mpdg837/BilberryPI/demo1.jpg

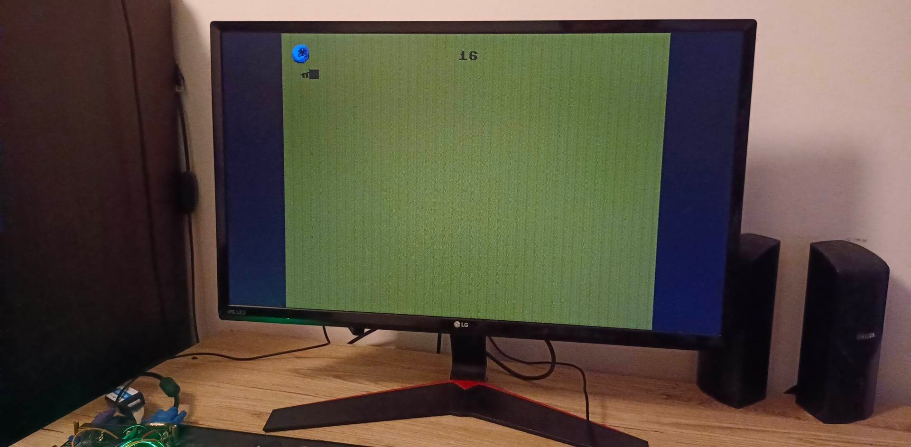
demo1.jpg
