mpdg837/BilberryPI/Hardware/GRAPHICS/PaletteController.v

module deltaController(
	input clk,
	input rst,
	
	input[23:0] in,
	input start,
	
	output reg delirq,
	
	output splash,
	
	output reg[4:0] deltaY,
	output reg[6:0] deltaX,
	
	output reg[4:0] bg1col1,
	output reg[4:0] bg1col2,
	output reg[4:0] bg1col3,
	output reg[4:0] bg1col4,
	
	output reg[4:0] bg2col1,
	output reg[4:0] bg2col2,
	output reg[4:0] bg2col3,
	output reg[4:0] bg2col4,
	
	output reg[4:0] bg3col1,
	output reg[4:0] bg3col2,
	output reg[4:0] bg3col3,
	output reg[4:0] bg3col4,
	
	output reg[4:0] bg4col1,
	output reg[4:0] bg4col2,
	output reg[4:0] bg4col3,
	output reg[4:0] bg4col4,
	
	output reg[4:0] bg5col1,
	output reg[4:0] bg5col2,
	output reg[4:0] bg5col3,
	output reg[4:0] bg5col4,
	
	output reg[4:0] bg6col1,
	output reg[4:0] bg6col2,
	output reg[4:0] bg6col3,
	output reg[4:0] bg6col4,
	
	output reg[4:0] bg7col1,
	output reg[4:0] bg7col2,
	output reg[4:0] bg7col3,
	output reg[4:0] bg7col4,
	
	output reg[4:0] bg8col1,
	output reg[4:0] bg8col2,
	output reg[4:0] bg8col3,
	output reg[4:0] bg8col4
	
);
reg n_splash =0;
reg f_splash = 0;

reg[4:0] f_deltaY;
reg[6:0] f_deltaX;

reg[4:0] f_bg1col1;
reg[4:0] f_bg1col2;
reg[4:0] f_bg1col3;
reg[4:0] f_bg1col4;

reg[4:0] f_bg2col1;
reg[4:0] f_bg2col2;
reg[4:0] f_bg2col3;
reg[4:0] f_bg2col4;

reg[4:0] f_bg3col1;
reg[4:0] f_bg3col2;
reg[4:0] f_bg3col3;
reg[4:0] f_bg3col4;

reg[4:0] f_bg4col1;
reg[4:0] f_bg4col2;
reg[4:0] f_bg4col3;
reg[4:0] f_bg4col4;

reg[4:0] f_bg5col1;
reg[4:0] f_bg5col2;
reg[4:0] f_bg5col3;
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
							bg6col4 = in[9:5];
						end
						6: begin
							bg7col3 = in[4:0];
							bg7col4 = in[9:5];
						end
						7: begin
							bg8col3 = in[4:0];
							bg8col4 = in[9:5];
						end
						default:;
					endcase
			default:;
		endcase
	
end

assign splash = ~n_splash;

endmodule
