mpdg837/BilberryPI/Hardware/GRAPHICS/sprites.v

module sprites(
	input clk,
	input dclk,
	input rst,
	input splash,
	
	input[3:0] uiin,
	
	input[4:0] bgcol2,
	input[4:0] bgcol3,
	input[4:0] bgcol4,
	
	input[8:0] ccy,
	input[9:0] ccx,
		
	input[31:0] fromRAM,
	output[15:0] addr,

	input[4:0] bcgcol,
	
	input xhsync,
	input xvsync,
	
	input ins,
	input sig,
	
	input[9:0] CounterX,
	input[8:0] CounterY,
	
	output comb,
	
	output R,
	output G,
	output B,
	
	output hsync,
	output vsync

	
);

wire[8:0] posX1;
wire[31:0] colors1;

wire[4:0] b1col1;
wire[4:0] b1col2;
wire[4:0] b1col3;
wire[4:0] b1col4;


wire[8:0] posX2;
wire[31:0] colors2;

wire[4:0] b2col1;
wire[4:0] b2col2;
wire[4:0] b2col3;
wire[4:0] b2col4;



wire[8:0] posX3;
wire[31:0] colors3;

wire[4:0] b3col1;
wire[4:0] b3col2;
wire[4:0] b3col3;
wire[4:0] b3col4;



wire[8:0] posX4;
wire[31:0] colors4;

wire[4:0] b4col1;
wire[4:0] b4col2;
wire[4:0] b4col3;
wire[4:0] b4col4;



wire[8:0] posX5;
wire[31:0] colors5;

wire[4:0] b5col1;
wire[4:0] b5col2;
wire[4:0] b5col3;
wire[4:0] b5col4;



wire[8:0] posX6;
wire[31:0] colors6;

wire[4:0] b6col1;
wire[4:0] b6col2;
wire[4:0] b6col3;
wire[4:0] b6col4;



wire[8:0] posX7;
wire[31:0] colors7;

wire[4:0] b7col1;
wire[4:0] b7col2;
wire[4:0] b7col3;
wire[4:0] b7col4;



wire[8:0] posX8;
wire[31:0] colors8;

wire[4:0] b8col1;
wire[4:0] b8col2;
wire[4:0] b8col3;
wire[4:0] b8col4;



wire[3:0] sclX1;
wire[3:0] sclX2;
wire[3:0] sclX3;
wire[3:0] sclX4;
wire[3:0] sclX5;
wire[3:0] sclX6;
wire[3:0] sclX7;
wire[3:0] sclX8;

wire swpX1;
wire swpX2;
wire swpX3;
wire swpX4;
wire swpX5;
wire swpX6;
wire swpX7;
wire swpX8;


wire[8:0] posX;
wire[31:0] colors;

wire[4:0] bcol1;
wire[4:0] bcol2;
wire[4:0] bcol3;
wire[4:0] bcol4;
wire[3:0] sclX;
wire swpX;

wire clr;
wire shift;


manager man(.clk(clk),
				.rst(rst),
				
				.shift(shift),
				.clr(clr),
				
				.uiin(uiin),
				
				.ccy(ccy),
				
				.CounterX(CounterX),
				.CounterY(CounterY),
				
				.fromRAM(fromRAM),
				.addr(addr),
	
				.posX1(posX),
				
				.colors1(colors),
				
				.b1col1(bcol1),
				.b1col2(bcol2),
				.b1col3(bcol3),
				.b1col4(bcol4),
				
				.sclX1(sclX),
				.swpX1(swpX)
				
				
);

wire[1:0] uicol;

uiconv uiC(.clk(clk),

			  .rst(rst),
			  .dclk(dclk),
			
			  .cx(CounterX),
			  .cy(CounterY),
	
			  .fromRAM(fromRAM),
	
			  .uicol(uicol)
);


shift sh1(.clk(clk),

			.rst(rst),	
	.clr(clr),
	.shift(shift),
	
	.i_posX(posX),
	.i_sclX(sclX),
	.i_swpX(swpX),
	
	.i_bcolor1(bcol1),
	.i_bcolor2(bcol2),
	.i_bcolor3(bcol3),
	.i_bcolor4(bcol4),
	
	.i_colors(colors),
	
	.posX(posX1),
	.sclX(sclX1),
	.swpX(swpX1),
	
	.bcolor1(b1col1),
	.bcolor2(b1col2),
	.bcolor3(b1col3),
	.bcolor4(b1col4),
	
	.colors(colors1)
	
	
);

shift sh2(.clk(clk),

	.rst(rst),	
	.clr(clr),
	.shift(shift),
	
	.i_posX(posX1),
	.i_sclX(sclX1),
	.i_swpX(swpX1),
	
	.i_bcolor1(b1col1),
	.i_bcolor2(b1col2),
	.i_bcolor3(b1col3),
	.i_bcolor4(b1col4),
	
	.i_colors(colors1),
	
	.posX(posX2),
	.sclX(sclX2),
	.swpX(swpX2),
	
	.bcolor1(b2col1),
	.bcolor2(b2col2),
	.bcolor3(b2col3),
	.bcolor4(b2col4),

	.colors(colors2)
	
	
);

shift sh3(.clk(clk),

	.rst(rst),	
	.clr(clr),
	.shift(shift),
	
	.i_posX(posX2),
	.i_sclX(sclX2),
	.i_swpX(swpX2),
	
	.i_bcolor1(b2col1),
	.i_bcolor2(b2col2),
	.i_bcolor3(b2col3),
	.i_bcolor4(b2col4),
	
	.i_colors(colors2),
	
	.posX(posX3),
	.sclX(sclX3),
	.swpX(swpX3),
	
	.bcolor1(b3col1),
	.bcolor2(b3col2),
	.bcolor3(b3col3),
	.bcolor4(b3col4),
	
	.colors(colors3)
	
	
);

shift sh4(.clk(clk),

	.rst(rst),	
	.clr(clr),
	.shift(shift),
	
	.i_posX(posX3),
	.i_sclX(sclX3),
	.i_swpX(swpX3),
	
	.i_bcolor1(b3col1),
	.i_bcolor2(b3col2),
	.i_bcolor3(b3col3),
	.i_bcolor4(b3col4),
	
	.i_colors(colors3),
	
	.posX(posX4),
	.sclX(sclX4),
	.swpX(swpX4),
	
	.bcolor1(b4col1),
	.bcolor2(b4col2),
	.bcolor3(b4col3),
	.bcolor4(b4col4),
	
	.colors(colors4)
	
	
);

shift sh5(.clk(clk),

	.rst(rst),	
	.clr(clr),
	.shift(shift),
	
	.i_posX(posX4),
	.i_sclX(sclX4),
	.i_swpX(swpX4),
	
	.i_bcolor1(b4col1),
	.i_bcolor2(b4col2),
	.i_bcolor3(b4col3),
	.i_bcolor4(b4col4),
	
	.i_colors(colors4),
	
	.posX(posX5),
	.sclX(sclX5),
	.swpX(swpX5),

	.bcolor1(b5col1),
	.bcolor2(b5col2),
	.bcolor3(b5col3),
	.bcolor4(b5col4),
	
	.colors(colors5)
	
	
);

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
	
	.colors(colors8),
	.posX(posX8),
	
	.CounterX(CounterX),
	
	.col(col8)
);

wire[4:0] ecol8;

palette palt8(.clk(dclk),
	
				 .scol(col8),
	
				 .col(ecol8),
				
				 .bcol1(b8col1),
				 .bcol2(b8col2),
				 .bcol3(b8col3),
				 .bcol4(b8col4),
				
					.d(d8)
);

wire[4:0] endcol;

collector cola(.d1(d1),
					.d2(d2),
					.d3(d3),
					.d4(d4),
					.d5(d5),
					.d6(d6),
					.d7(d7 & 0),
					.d8(d8 & 0),
					
					.bcgcol(bcgcol),
					
					.ecol1(ecol1), 
					.ecol2(ecol2), 
					.ecol3(ecol3), 
					.ecol4(ecol4), 
					.ecol5(ecol5), 
					.ecol6(ecol6),
					.ecol7(ecol7 & 0),
					.ecol8(ecol8 & 0),

					.out(endcol)  	
);

wire[4:0] oocol;

ui u(.clk(dclk),
	
		.uiin(uicol),
		
		.bgcol2(bgcol2),
		.bgcol3(bgcol3),
		.bgcol4(bgcol4),
		
	  .in(endcol),
	
	  .out(oocol)
);


lastBlock lB(.dclk(dclk),
				 .splash(splash),
				 .clk(clk),
				 .rst(rst),
				 
				 .xhsync(xhsync),
				 .xvsync(xvsync),
	
				 .col(oocol),
				 .ins(ins),
				 .CounterX(CounterX),
				 .CounterY(CounterY),
	
				 .hsync(hsync),
				 .vsync(vsync),
	
				 .R(R),
				 .G(G),
				 .B(B),
				 
				
);

endmodule

module ui(
	input clk,
	
	input[9:0] CounterX,
	input[8:0] CounterY,
	
	input[4:0] in,
	
	input[1:0] uiin,
	
	input[4:0] bgcol2,
	input[4:0] bgcol3,
	input[4:0] bgcol4,
	
	output reg[4:0] out
);

always@(posedge clk)begin

	case(uiin)
		1: out <= bgcol2;
		2: out <= bgcol3;
		3: out <= bgcol4;
		default: out <= in;
	endcase

end


endmodule
