mpdg837/BilberryPI/(commit log)

2022-08-04 First addition
    [ALU.csv]
2022-08-20 Remake old instructions
    [ALU.csv]
2022-08-30 Update compiler and firmware
    [ALU.csv]
2022-12-28 Prepare project for new circuit
    [ALU.csv]
2022-12-28 Update driver for music module
2022-12-31 Adding 3-sound sound module
    [ALU.csv]
2023-01-01 Implement DMA to sound module to play 8-bit samples
    [ALU.csv]
2023-02-05 Higher frequency of main clock
    [ALU.csv]
2023-02-15 Add interupt queue
    [ALU.csv]
